AAAxiaohuangyu/2027ROBOCONSummerCamp/Docs/09FABCCCBEF35BF6D9F692935170EADD.png

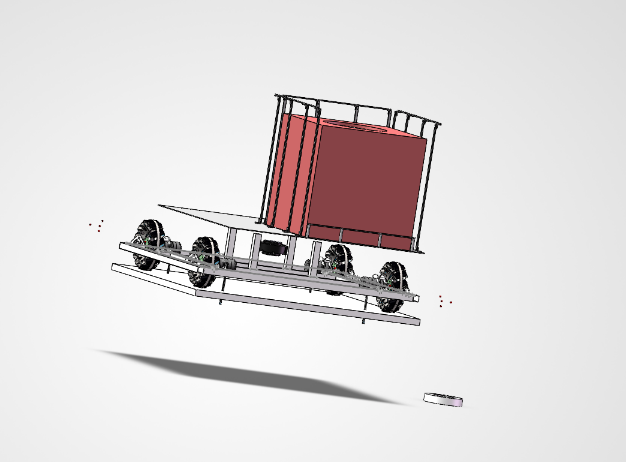
Docs/09FABCCCBEF35BF6D9F692935170EADD.png
