AAAxiaohuangyu/2027ROBOCONSummerCamp/Docs/84D7E0D3EE25D9967A4F5F0365C8E441.png

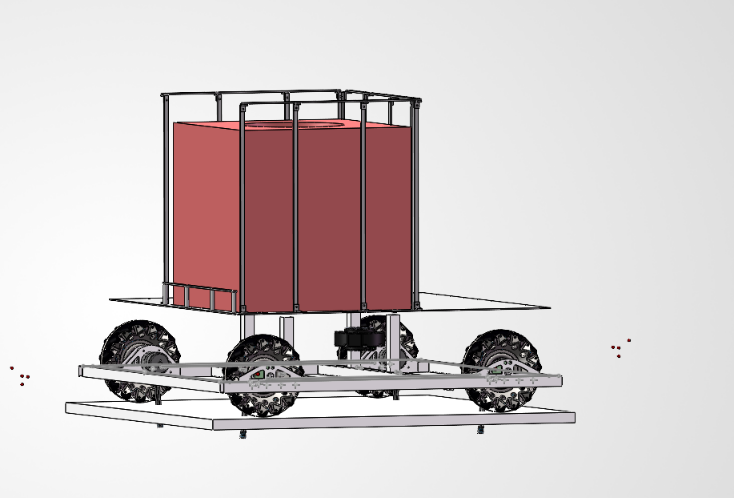
Docs/84D7E0D3EE25D9967A4F5F0365C8E441.png
