AAAxiaohuangyu/2027ROBOCONSummerCamp/Docs/97BEFC750FC481E44ABCBB74B873D2FB.png

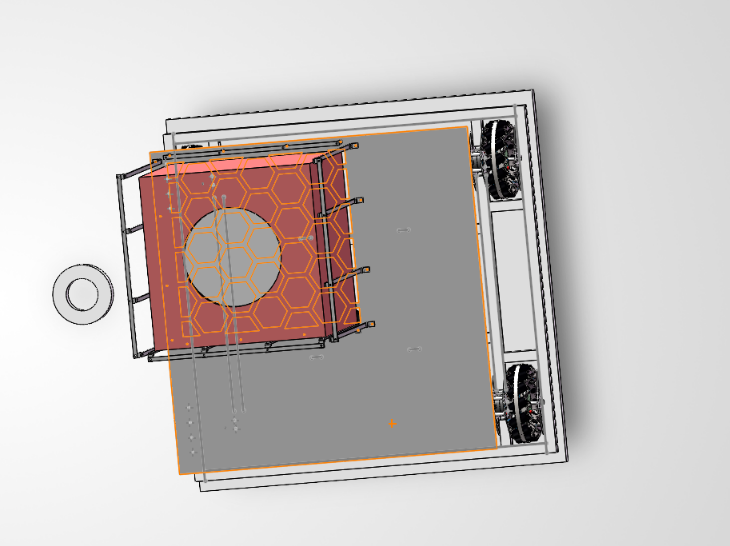
Docs/97BEFC750FC481E44ABCBB74B873D2FB.png
