AAAxiaohuangyu/2027ROBOCONSummerCamp/Docs/EFC362A279160BEA5BCEA1ED6BABFD79.png

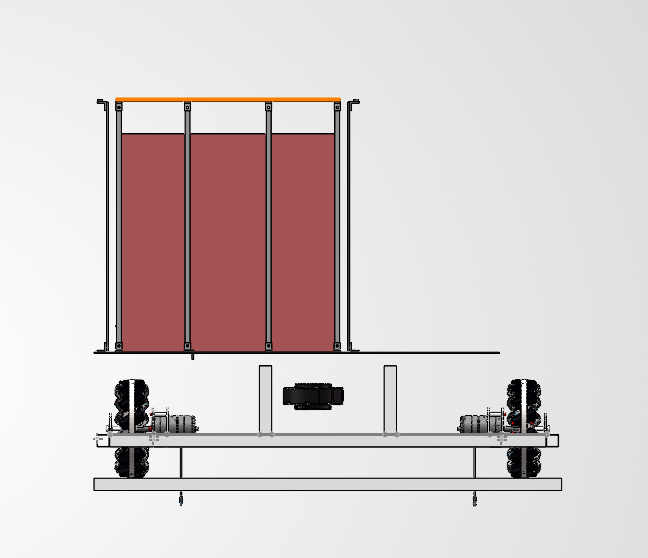
Docs/EFC362A279160BEA5BCEA1ED6BABFD79.png
