AAAxiaohuangyu/2027ROBOCONSummerCamp/Docs/SCH_Schematic1_2026-08-18.pdf

VDD 72 PB12 73 PB13 74 PB14 75 PB15 76 PD8 77 PD9 78 PD10 79 PD11 80 PD12 81 PD13 82 VSS 83 VDD 84 PD14 85 PD15 86 PG2 87 PG3 88 PG4 89 PG5 90 PG6 91 PG7 92 PG8 93 VSS 94 VDD33USB 95 PC6 96 PC7 97 PC8 98 PC9 99 PA8 100 PA9 101 PA10 102 PA11 103 PA12 104 PA13 105 VCAP 106 VSS 107 VDD 108 PA14 109 PA15 110 PC10 111 PC11 112 PC12 113 PD0 114 PD1 115 PD2 116 PD3 117 PD4 118 PD5 119 VSS 120 VDD 121 PD6 122 PD7 123 PG9 124 PG10 125 PG11 126 PG12 127 PG13 128 PG14 129 VSS 130 VDD 131 PG15 132 PB3 133 PB4 134 PB5 135 PB6 136 PB7 137 BOOT0 138 PB8 139 PB9 140 PE0 141 PE1 142 PDR_ON 143 VDD 144

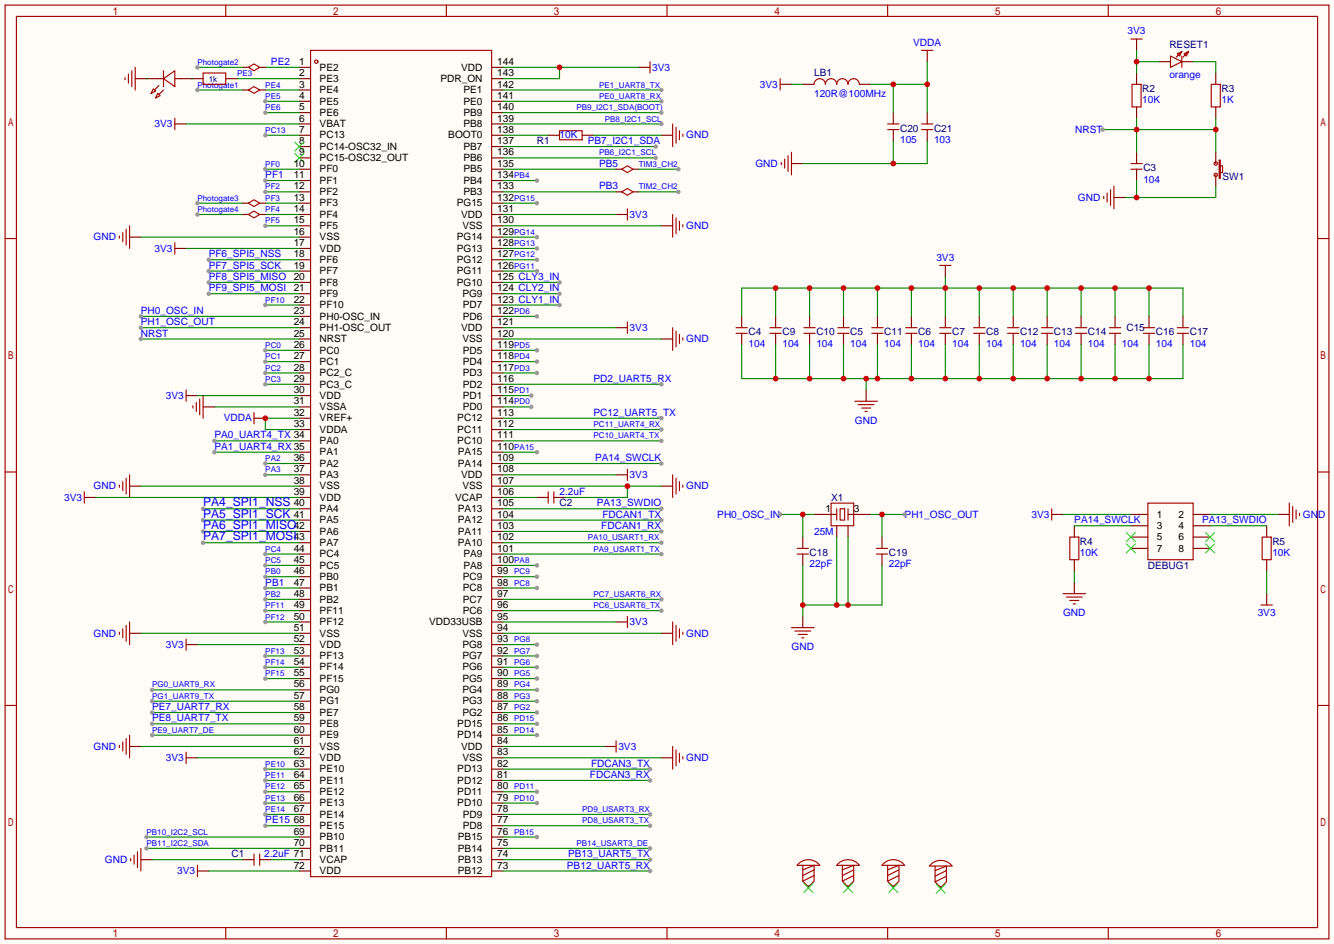
[picture p5: page 1]

# 电源降压

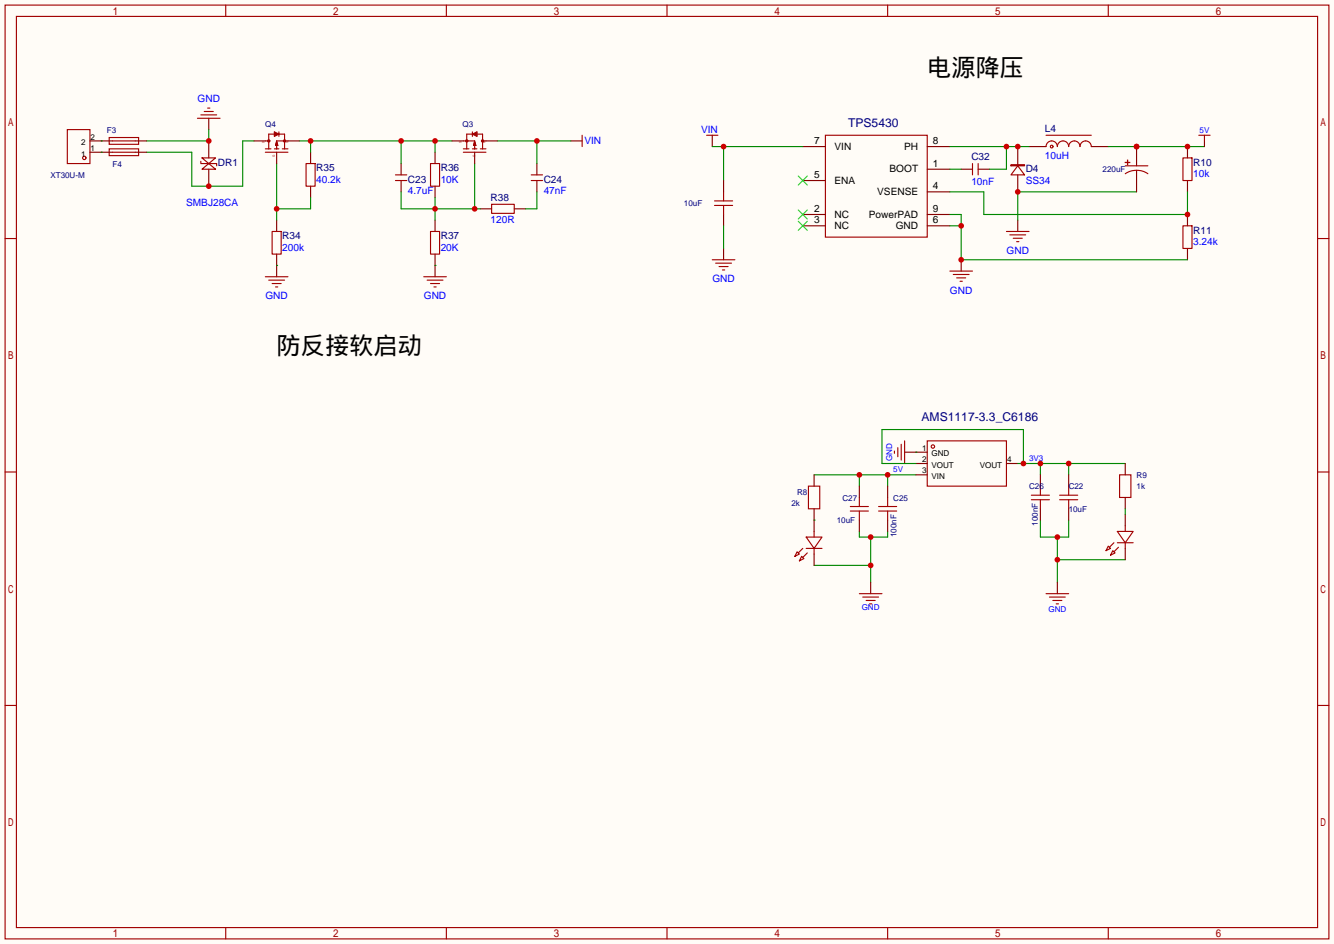
[picture p6: page 2]

# FDCAN

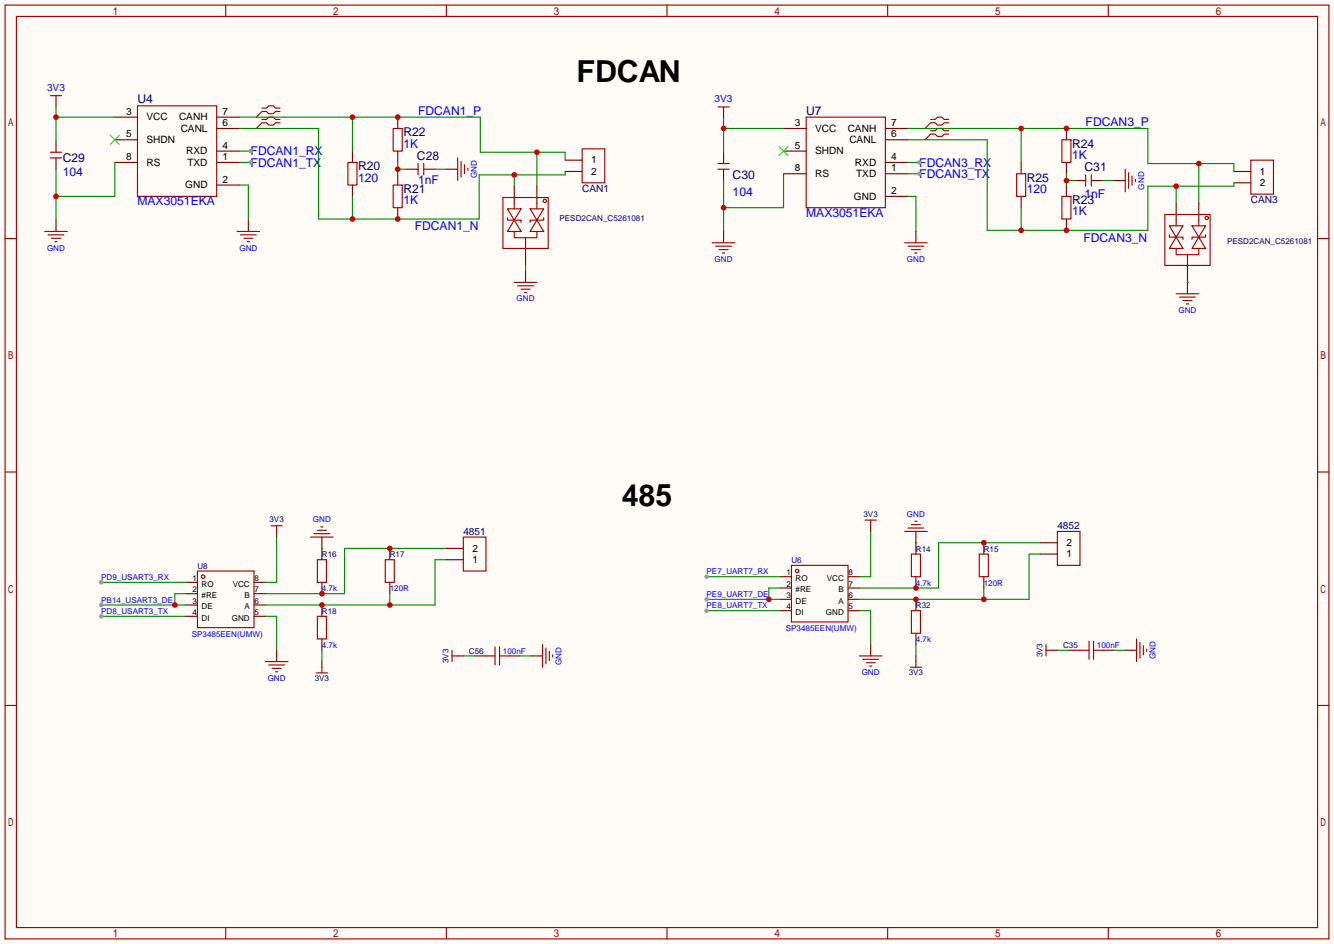
[picture p7: page 3]

# 光电门

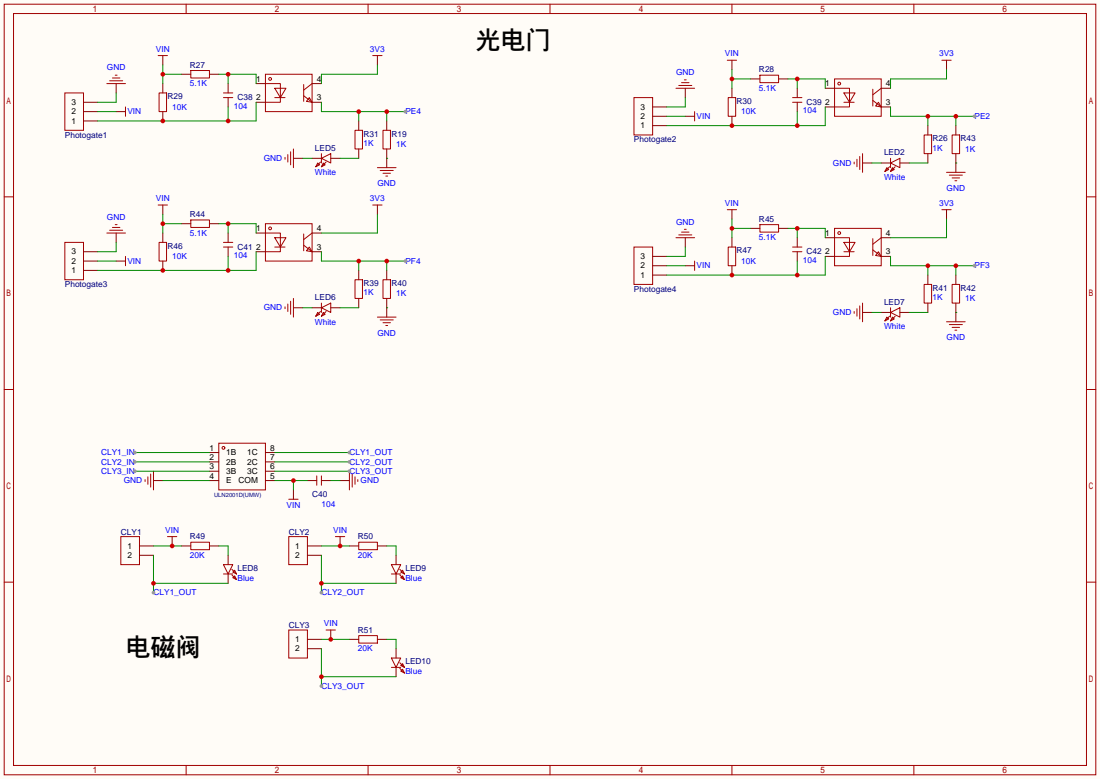
[picture p8: page 4]

# SPI

# USB to TTL

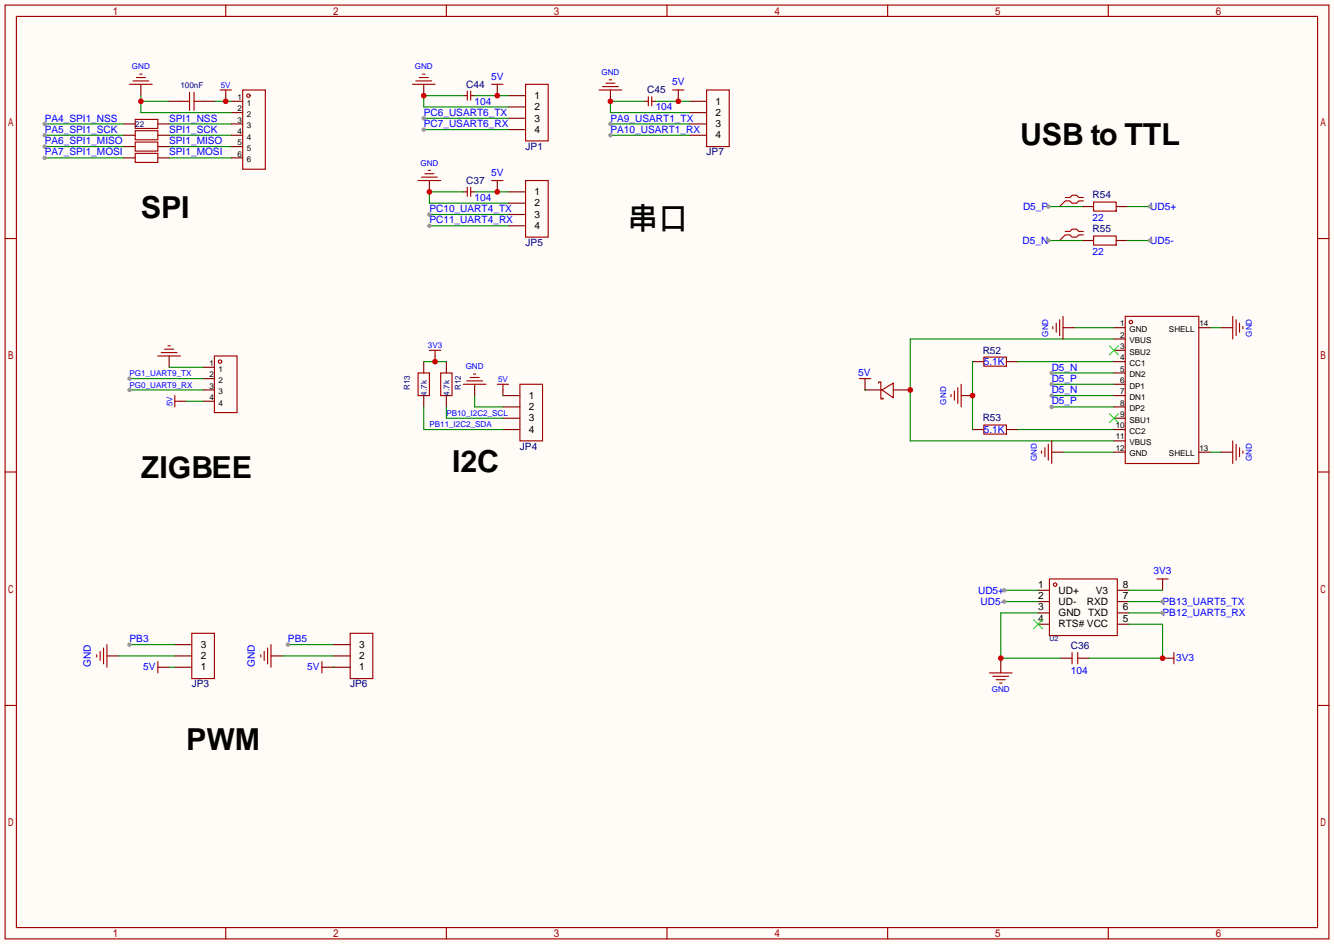
[picture p9: page 5]
