AAAxiaohuangyu/2027ROBOCONSummerCamp/RobotLower computer/RobotLower computer.ioc

Mcu.UserName=STM32H723ZGTx
PA10.Signal=USART1_RX
PA11.Signal=FDCAN1_RX
PA12.Signal=FDCAN1_TX
PA13(JTMS/SWDIO).Signal=DEBUG_JTMS-SWDIO
PA14(JTCK/SWCLK).Signal=DEBUG_JTCK-SWCLK
PA9.Signal=USART1_TX
PB12.Signal=UART5_RX
PB13.Signal=UART5_TX
PB14.Signal=USART3_DE
PB3(JTDO/TRACESWO).Signal=GPIO_Output
PB5.Signal=S_TIM3_CH2
PC10.Signal=UART4_TX
PC11.Signal=UART4_RX
PC14-OSC32_IN.Signal=RCC_OSC32_IN
PC15-OSC32_OUT.Signal=RCC_OSC32_OUT
PD12.Signal=FDCAN3_RX
PD13.Signal=FDCAN3_TX
PD7.Signal=GPIO_Output
PD8.Signal=USART3_TX
PD9.Signal=USART3_RX
PG0.Signal=UART9_RX
PG1.Signal=UART9_TX
PH0-OSC_IN.Signal=RCC_OSC_IN
PH1-OSC_OUT.Signal=RCC_OSC_OUT
