AAAxiaohuangyu/2027ROBOCONSummerCamp/RobotLower computer/APP/Common/GO_M8010.c

#include "GO_M8010.h"
#include <string.h>
#include "Core.h"

#define SATURATE(_IN, _MIN, _MAX) \
    do {                           \
        if ((_IN) <= (_MIN))      \
            (_IN) = (_MIN);       \
        else if ((_IN) >= (_MAX)) \
            (_IN) = (_MAX);       \
    } while (0)

/* CRC-16/CCITT(反射多项式0x8408,对应正规多项式0x1021)查找表,与GO-M8010-6协议一致 */
static const uint16_t crc_ccitt_table[256] = {
	0x0000, 0x1189, 0x2312, 0x329b, 0x4624, 0x57ad, 0x6536, 0x74bf,
	0x8c48, 0x9dc1, 0xaf5a, 0xbed3, 0xca6c, 0xdbe5, 0xe97e, 0xf8f7,
	0x1081, 0x0108, 0x3393, 0x221a, 0x56a5, 0x472c, 0x75b7, 0x643e,
	0x9cc9, 0x8d40, 0xbfdb, 0xae52, 0xdaed, 0xcb64, 0xf9ff, 0xe876,
	0x2102, 0x308b, 0x0210, 0x1399, 0x6726, 0x76af, 0x4434, 0x55bd,
	0xad4a, 0xbcc3, 0x8e58, 0x9fd1, 0xeb6e, 0xfae7, 0xc87c, 0xd9f5,
	0x3183, 0x200a, 0x1291, 0x0318, 0x77a7, 0x662e, 0x54b5, 0x453c,
	0xbdcb, 0xac42, 0x9ed9, 0x8f50, 0xfbef, 0xea66, 0xd8fd, 0xc974,
	0x4204, 0x538d, 0x6116, 0x709f, 0x0420, 0x15a9, 0x2732, 0x36bb,
	0xce4c, 0xdfc5, 0xed5e, 0xfcd7, 0x8868, 0x99e1, 0xab7a, 0xbaf3,
	0x5285, 0x430c, 0x7197, 0x601e, 0x14a1, 0x0528, 0x37b3, 0x263a,
	0xdecd, 0xcf44, 0xfddf, 0xec56, 0x98e9, 0x8960, 0xbbfb, 0xaa72,
	0x6306, 0x728f, 0x4014, 0x519d, 0x2522, 0x34ab, 0x0630, 0x17b9,
	0xef4e, 0xfec7, 0xcc5c, 0xddd5, 0xa96a, 0xb8e3, 0x8a78, 0x9bf1,
	0x7387, 0x620e, 0x5095, 0x411c, 0x35a3, 0x242a, 0x16b1, 0x0738,
	0xffcf, 0xee46, 0xdcdd, 0xcd54, 0xb9eb, 0xa862, 0x9af9, 0x8b70,
	0x8408, 0x9581, 0xa71a, 0xb693, 0xc22c, 0xd3a5, 0xe13e, 0xf0b7,
	0x0840, 0x19c9, 0x2b52, 0x3adb, 0x4e64, 0x5fed, 0x6d76, 0x7cff,
	0x9489, 0x8500, 0xb79b, 0xa612, 0xd2ad, 0xc324, 0xf1bf, 0xe036,
	0x18c1, 0x0948, 0x3bd3, 0x2a5a, 0x5ee5, 0x4f6c, 0x7df7, 0x6c7e,
	0xa50a, 0xb483, 0x8618, 0x9791, 0xe32e, 0xf2a7, 0xc03c, 0xd1b5,
	0x2942, 0x38cb, 0x0a50, 0x1bd9, 0x6f66, 0x7eef, 0x4c74, 0x5dfd,
	0xb58b, 0xa402, 0x9699, 0x8710, 0xf3af, 0xe226, 0xd0bd, 0xc134,
	0x39c3, 0x284a, 0x1ad1, 0x0b58, 0x7fe7, 0x6e6e, 0x5cf5, 0x4d7c,
	0xc60c, 0xd785, 0xe51e, 0xf497, 0x8028, 0x91a1, 0xa33a, 0xb2b3,
	0x4a44, 0x5bcd, 0x6956, 0x78df, 0x0c60, 0x1de9, 0x2f72, 0x3efb,
	0xd68d, 0xc704, 0xf59f, 0xe416, 0x90a9, 0x8120, 0xb3bb, 0xa232,
	0x5ac5, 0x4b4c, 0x79d7, 0x685e, 0x1ce1, 0x0d68, 0x3ff3, 0x2e7a,
	0xe70e, 0xf687, 0xc41c, 0xd595, 0xa12a, 0xb0a3, 0x8238, 0x93b1,
	0x6b46, 0x7acf, 0x4854, 0x59dd, 0x2d62, 0x3ceb, 0x0e70, 0x1ff9,
	0xf78f, 0xe606, 0xd49d, 0xc514, 0xb1ab, 0xa022, 0x92b9, 0x8330,
	0x7bc7, 0x6a4e, 0x58d5, 0x495c, 0x3de3, 0x2c6a, 0x1ef1, 0x0f78
};

static uint16_t crc_ccitt_byte(uint16_t crc, uint8_t byte)
{
    return (crc >> 8) ^ crc_ccitt_table[(crc ^ (uint16_t)byte) & 0xFFU];
}

static uint16_t crc_ccitt(uint16_t crc, const uint8_t *buffer, size_t len)
{
    while (len-- > 0U)
        crc = crc_ccitt_byte(crc, *buffer++);
    return crc;
}

static void go_m8010_put_u16_le(uint8_t *dst, uint16_t value)
{
    dst[0] = (uint8_t)(value & 0xFFU);
    dst[1] = (uint8_t)((value >> 8) & 0xFFU);
}

static void go_m8010_put_u32_le(uint8_t *dst, uint32_t value)
{
    dst[0] = (uint8_t)(value & 0xFFU);
    dst[1] = (uint8_t)((value >> 8) & 0xFFU);
    dst[2] = (uint8_t)((value >> 16) & 0xFFU);
    dst[3] = (uint8_t)((value >> 24) & 0xFFU);
}

static uint16_t go_m8010_get_u16_le(const uint8_t *src)
{
    return (uint16_t)src[0] | ((uint16_t)src[1] << 8);
}

static uint32_t go_m8010_get_u32_le(const uint8_t *src)
{
    return (uint32_t)src[0] |
           ((uint32_t)src[1] << 8) |
           ((uint32_t)src[2] << 16) |
           ((uint32_t)src[3] << 24);
}

/* 输出端->转子侧:扭矩经减速器放大,按减速比乘;速度/位置经减速器缩小,按减速比除 */
static float go_m8010_torque_output_to_rotor(float torque_output)
{
    return torque_output / GO_M8010_REDUCTION_RATIO;
}

static float go_m8010_speed_output_to_rotor(float speed_output)
{
    return speed_output * GO_M8010_REDUCTION_RATIO;
}

static float go_m8010_position_output_to_rotor(float position_output)
{
    return position_output * GO_M8010_REDUCTION_RATIO;
}

/* 转子侧->输出端:与上面互为逆运算 */
static float go_m8010_position_rotor_to_output(float position_rotor)
{
    return position_rotor / GO_M8010_REDUCTION_RATIO;
}

/* 按GO-M8010-6协议打包17字节控制帧,限幅后转换为定点数,不回写调用者原始指令 */
static void GOM8010PackControlFrame(GOM8010Motor_TypeDef *motor)
{
    GOM8010Control_TypeDef *control = &motor->control;
    uint8_t *frame = control->packet.bytes;
    uint8_t id = motor->id;
    uint8_t mode = control->mode;
    uint8_t timeout = control->timeout;
    float torque = go_m8010_torque_output_to_rotor(control->torque);
    float speed = go_m8010_speed_output_to_rotor(control->speed);
    /* control->position是软件零点坐标系(与feedback->position同系),打包发送前需加回position_offset
       换算回电机原始坐标系,否则电机实际运动位置会偏差一个position_offset */
    float position = go_m8010_position_output_to_rotor(control->position + motor->feedback.position_offset);
    float kp = control->kp;
    float kd = control->kd;
    int16_t torque_raw;
    int16_t speed_raw;
    int32_t position_raw;
    int16_t kp_raw;
    int16_t kd_raw;
    uint16_t crc;

    if (id > 15U)      /* id占4bit */
        id = 15U;
    if (mode > 2U)     /* 0=锁定,1=FOC闭环(力位速混合控制,常用模式),2=编码器校准 */
        mode = 2U;
    if (timeout > 1U)
        timeout = 1U;
    SATURATE(kp, 0.0f, 25.599f);              /* kp/kd满量程25.6,对应16bit定点 */
    SATURATE(kd, 0.0f, 25.599f);
    SATURATE(torque, -4.0f, 4.0f);            /* 转子侧额定最大转矩±4N*m(已由输出端换算而来) */
    SATURATE(speed, -804.0f, 804.0f);         /* 转子侧最大转速±804rad/s,由16bit定点满量程反推 */
    SATURATE(position, -411774.0f, 411774.0f); /* 转子侧位置范围,由32bit定点满量程反推 */

    torque_raw = (int16_t)(torque * 256.0f);
    speed_raw = (int16_t)(speed / PI2 * 256.0f);
    position_raw = (int32_t)(position / PI2 * 32768.0f);
    kp_raw = (int16_t)(kp / 25.6f * 32768.0f);
    kd_raw = (int16_t)(kd / 25.6f * 32768.0f);

    frame[0] = 0xFEU; /* 控制帧帧头 */
    frame[1] = 0xEEU;
    frame[2] = (uint8_t)((id & 0x0FU) |
                         ((mode & 0x07U) << 4) |
                         ((timeout & 0x01U) << 7));
    go_m8010_put_u16_le(&frame[3], (uint16_t)torque_raw);
    go_m8010_put_u16_le(&frame[5], (uint16_t)speed_raw);
    go_m8010_put_u32_le(&frame[7], (uint32_t)position_raw);
    go_m8010_put_u16_le(&frame[11], (uint16_t)kp_raw);
    go_m8010_put_u16_le(&frame[13], (uint16_t)kd_raw);

    crc = crc_ccitt(0U, frame, 15U); /* CRC覆盖帧头+数据共15字节 */
    go_m8010_put_u16_le(&frame[15], crc);
}

/* 校验16字节反馈帧并提取位置；第一帧作为软件零点。 */
static uint8_t GOM8010ParseFeedbackFrame(GOM8010Feedback_TypeDef *feedback, const uint8_t *frame)
{
    uint16_t received_crc;
    uint16_t calculated_crc;
    int32_t position_raw;
    float position_output;

    if ((frame[0] != 0xFDU) || (frame[1] != 0xEEU))
        return 0U;

    calculated_crc = crc_ccitt(0U, frame, 14U);
    received_crc = go_m8010_get_u16_le(&frame[14]);
    if (received_crc != calculated_crc)
        return 0U;

    position_raw = (int32_t)go_m8010_get_u32_le(&frame[7]);
    position_output = go_m8010_position_rotor_to_output((float)position_raw / 32768.0f * PI2);
    if (feedback->position_initialized == 0U)
    {
        feedback->position_offset = position_output;
        feedback->position_initialized = 1U;
    }

    feedback->position = position_output - feedback->position_offset;
    return 1U;
}

static void GOM8010MotorParseFeedback(GOM8010Motor_TypeDef *motor, uint16_t size)
{
    uint16_t offset;
    const uint8_t *latest_frame = NULL;

    if (size > GO_M8010_RX_DMA_BUFFER_SIZE)
        size = GO_M8010_RX_DMA_BUFFER_SIZE;

    for (offset = 0U; (offset + GO_M8010_FEEDBACK_FRAME_SIZE) <= size; offset++)
    {
        if (GOM8010ParseFeedbackFrame(&motor->feedback, &motor->feedback.packet.bytes[offset]) != 0U)
        {
            latest_frame = &motor->feedback.packet.bytes[offset];
        }
    }

    if (latest_frame != NULL)
        memmove(motor->feedback.packet.bytes, latest_frame, GO_M8010_FEEDBACK_FRAME_SIZE);
}

static void GOM8010MotorStartRx(GOM8010Motor_TypeDef *motor)
{
    HAL_UARTEx_ReceiveToIdle_DMA(motor->huart, motor->feedback.packet.bytes, GO_M8010_RX_DMA_BUFFER_SIZE);
    __HAL_DMA_DISABLE_IT(motor->huart->hdmarx, DMA_IT_HT);
}

void GOM8010MotorInit(GOM8010Motor_TypeDef *motor, uint8_t id, UART_HandleTypeDef *huart)
{
    memset(motor, 0, sizeof(*motor));
    motor->id = id;
    motor->huart = huart;
    motor->control.mode = 1U;

    motor->control.position_param.a_max = GO_M8010_POS_CTRL_A_MAX;
    motor->control.position_param.v_max = GO_M8010_POS_CTRL_V_MAX;
    motor->control.position_param.j = GO_M8010_POS_CTRL_J;
    motor->control.position_param.kp = GO_M8010_POS_CTRL_KP;
    motor->control.position_param.kd = GO_M8010_POS_CTRL_KD;
    motor->control.velocity_param.kp = GO_M8010_VEL_CTRL_KP;
    motor->control.velocity_param.kd = GO_M8010_VEL_CTRL_KD;

    SpeedPlanInit(&motor->control.plan, motor->control.position_param.a_max, motor->control.position_param.v_max, motor->control.position_param.j, 0.0f);
    motor->control.ctrl_mode = GOM8010_CTRL_MODE_POSITION;
    motor->control.kp = motor->control.position_param.kp;
    motor->control.kd = motor->control.position_param.kd;

    GOM8010MotorStartRx(motor);
}

void GOM8010MotorSetTarget(GOM8010Motor_TypeDef *motor, float position_target)
{
    motor->control.ctrl_mode = GOM8010_CTRL_MODE_POSITION;
    motor->control.position_target = position_target;
    motor->control.plan.state = init;
}

void GOM8010MotorSetVelocityTarget(GOM8010Motor_TypeDef *motor, float velocity_target)
{
    motor->control.ctrl_mode = GOM8010_CTRL_MODE_VELOCITY;
    motor->control.velocity_target = velocity_target;
}

void GOM8010MotorSetTorqueFeedforward(GOM8010Motor_TypeDef *motor, float torque_feedforward)
{
    motor->control.torque_feedforward = torque_feedforward;
}

void GOM8010MotorUpdate(GOM8010Motor_TypeDef *motor)
{
    GOM8010Control_TypeDef *control = &motor->control;
    float position_actual = motor->feedback.position;

    control->mode = 1U;
    control->timeout = 0U;
    control->torque = control->torque_feedforward;

    if (control->ctrl_mode == GOM8010_CTRL_MODE_VELOCITY)
    {
        control->kp = control->velocity_param.kp;
        control->kd = control->velocity_param.kd;
        control->position = position_actual;
        control->speed = control->velocity_target;
    }
    else
    {
        SpeedPlanUpdate(&control->plan, position_actual, control->position_target);
        control->kp = control->position_param.kp;
        control->kd = control->position_param.kd;
        control->position = control->plan.position_initial + control->plan.direction_flag * control->plan.s;
        control->speed = control->plan.v * control->plan.direction_flag;
    }

    GOM8010PackControlFrame(motor);
    HAL_UART_Transmit_DMA(motor->huart, control->packet.bytes, GO_M8010_CONTROL_FRAME_SIZE);
}

void GOM8010MotorRxEvent(GOM8010Motor_TypeDef *motor, UART_HandleTypeDef *huart, uint16_t size)
{
    if (huart == NULL || motor->huart == NULL || motor->huart->Instance != huart->Instance)
        return;
    GOM8010MotorParseFeedback(motor, size);
    GOM8010MotorStartRx(motor);
}

void GOM8010MotorRxErrorEvent(GOM8010Motor_TypeDef *motor, UART_HandleTypeDef *huart)
{
    if (huart == NULL || motor->huart == NULL || motor->huart->Instance != huart->Instance)
        return;

    GOM8010MotorStartRx(motor);
}
