AAAxiaohuangyu/2027ROBOCONSummerCamp/(commit log)

2026-08-10 Add STM32CubeMX+FreeRTOS lower-computer skeleton (chassis/flip/pickup/stack)
    [RobotLower computer.ioc]
2026-08-10 进行了基础的时钟树配置,FDCAN配置,USART配置,FreeRTOS配置
2026-08-10 feat(common): 新增FDCAN总线1与调试USART1的共享语义化宏定义
2026-08-10 feat(common): 新增FDCAN公共收发接口(fdcan_common)
    提供 FDCANStandardInit（标准ID范围过滤器配置+启动）与 FDCANSendStandard
    （标准帧发送）供各模块复用。
2026-08-10 chore(common): 将fdcan_common接入Keil工程
    补充 APP/Common 头文件搜索路径，并把 fdcan_common.c 加入编译分组。
2026-08-10 style(common): 完善fdcan_common注释与格式
2026-08-10 refactor(common): bsp_config总线句柄改为取地址形式并新增DEBUG_UART_INSTANCE
    FDCAN1启用Normal模式;清理freertos.c格式并移除遗留的测试任务引用
2026-08-10 docs: 更新2026夏令营赛题文档
2026-08-10 docs: add J60 joint product manual
2026-08-10 feat(common): 新增ControlAlgorithm串级PID公共算法模块
    封装单环PID(PIDCalc)与位置-速度串级PID(CascadePIDCalc),
    含输出限幅与积分限幅;接入Keil工程Common分组
2026-08-11 feat(common): 新增SpeedPlan七段S曲线速度规划公共算法模块
    封装SpeedPlanInit/SpeedPlanUpdate,内部按1ms子步长积分且按HAL_GetTick()
    计算真实dt,调用频率不影响规划精度;接入Keil工程Common分组
2026-08-11 feat(common): 新增GO-M8010-6电机RS485驱动模块
    - 控制/反馈帧打包解析、CRC-16/CCITT校验等内部实现收敛至.c,头文件只暴露类型与3个公共接口
    - 支持多UART实例(huart字段),避免全局固定USART_NUM
    - 发送采用DMA,接收由上层空闲线中断驱动后调用GOM8010MotorParseFeedback解析,驱动本身不含中断回调
    - 类型/函数统一GOM8010前缀命名,对齐DJIMotor等驱动的品牌命名规范,避免多品牌电机命名冲突
2026-08-11 feat(common): 新增GO-M8010-6电机驱动模块
    支持控制帧打包/反馈帧解析,对外接口统一使用输出端力矩/转速/位置,内部按6.33减速比与协议约定的转子侧数据互相换算。
2026-08-11 feat(common): GO_M8010驱动内置速度规划位置环API
    新增GOM8010PositionControl_TypeDef,把SpeedPlan规划与力位速混合控制
    封装为驱动API(Init/SetTarget/Update),kp/kd及规划参数固化为调好的默认值。
2026-08-12 refactor(common): GO_M8010电机结构体模仿M3508模式重构,新增M3508驱动模块
    - GO_M8010驱动引入GOM8010Motor_TypeDef大结构体,内含control/feedback子结构体,与M3508驱动风格保持一致(GO电机走RS485点对点通信,不引入分组结构)
    - 新增APP/Common/M3508.c/h(原APP/Test/DJIMotor.c/h重命名迁移),标识符同步由DJIMotor/DJI_MOTOR/DJI_M3508前缀改为M3508
2026-08-12 feat(common): 新增bsp_callback回调统一管理占位文件,CANBUS1切换至hfdcan2
    - 新增APP/Common/bsp_callback.c/h作为后续统一承载HAL弱回调(HAL_UARTEx_RxEventCallback等)分发逻辑的占位文件,避免多任务文件各自定义同名回调导致链接冲突
    - bsp_config.h的CANBUS1_HANDLE由hfdcan1改为hfdcan2
2026-08-12 feat(common): 新增J60关节电机CAN驱动,GO_M8010/J60支持前馈扭矩由上层指定
    - 新增APP/Common/J60.c/h:J60关节电机CAN通信协议驱动,内置速度规划位置环,与GO_M8010风格一致
    - GO_M8010/J60的torque前馈不再硬编码为0,新增GOM8010MotorSetTorqueFeedforward/J60MotorSetTorqueFeedforward,可由上层像目标位置/速度一样指定前馈扭矩
2026-08-12 feat(common): J60/M3508驱动写死最终调参参数,工程新增J60/M3508/bsp_callback源文件
    按GO_M8010驱动风格,将J60位置环kp/kd、M3508速度环+电流环级联PID的最终调参值
    直接写死在各自头文件的默认参数宏中;同步将新增的J60.c/M3508.c/bsp_callback.c
    加入Keil工程文件,使其参与编译。
2026-08-12 feat(common): 新增机械臂末端坐标控制模块(J60升降+GO前伸+GO自转)
    RoboticArm在J60/GO_M8010驱动之上建模三自由度末端执行器:升降高度、
    前伸距离共同决定末端点end_x/end_z,另有末端自转角度rod_rotation与
    自转电机转角直接相等;安装位置/换算系数/杆长均以宏定义占位,待实测标定。
2026-08-12 chore: 移除空的APP/Stack占位目录
2026-08-13 feat(common): 机械臂标定升降/前后减速比,新增末端z向固定偏移量
    ROBOTICARM_LIFT_K/ROBOTICARM_FORWARD_K填入实测减速比0.00955;新增
    ROBOTICARM_END_Z_OFFSET(实测84mm),修正末端结构导致的z向固定高出量,
    末端坐标正解/反解均已同步该偏移。
    [RoboticArm.c, RoboticArm.h]
2026-08-13 feat(common): 机械臂全局实例定义,新增Core应用层文件,文档补充
2026-08-13 feat(core): Core状态机骨架接入机械臂实例,移除RoboticArm独立全局实例
2026-08-13 feat(core): RobotInit接入机械臂初始化,bsp_config.h迁移至Core并新增机械臂外设占位宏
2026-08-13 feat(zigbee): 接收指针参数重构,移除全局实例依赖
    - 所有Zigbee_*函数改为接收ZigbeeHandle_TypeDef指针参数
    - 符合RoboticArm模块指针传递的设计模式
    - HAL_UARTEx_RxEventCallback内部路由到Robot.zigbee实例
    - 新增flip.c/flip.h和zigbee驱动完整实现
    [Core.h, zigbee.c, zigbee.h]
2026-08-13 feat(common): add gas pump GPIO driver
    Control gas pump on/off via a single GPIO pin for robotic arm grip/release actions.
2026-08-13 feat(core): add robot state machine skeleton and update loop
    Introduce RobotState_TypeDef with idle state and wire RobotStateUpdate/RoboticArmUpdate into dedicated update loops.
2026-08-13 feat(pickup): add KFS pickup state machine
    Extract shared PositionReached/RotationReached helpers from Flip into RoboticArm and reuse them to drive the new Pickup state machine.
    [RoboticArm.c, RoboticArm.h]
2026-08-13 fix(common): add osDelay in RoboticArmUpdate loop
    Yield CPU periodically inside the update loop to avoid starving other RTOS tasks.
    [RoboticArm.c]
2026-08-13 feat(chassis): add mecanum chassis module, move RoboticArm to own directory
    Adds Chassis/chassis.c,h with mecanum kinematics (chassis_mecanum.c,h) and a
    centralized chassis_config.h for calibration and drivetrain unit-conversion
    constants. Chassis_TypeDef groups drive/displacement-plan/pose sub-structs
    instead of flat fields. Relocates RoboticArm from APP/Common to its own
    APP/Roboticarm directory, and updates the Keil project/include paths and
    VS Code IntelliSense config accordingly.
2026-08-13 feat(core): wire chassis module into robot state, dispatch its CAN feedback
    Init the chassis in RobotInit and route its FDCAN feedback through the
    shared HAL callback dispatcher alongside the lift motor. Rename zigbee.h's
    protocol payload struct (ZigbeeChassisCmd_TypeDef) to stop colliding with
    chassis.h's Chassis_TypeDef, which broke the build with a redeclaration
    error and made Robot.chassis resolve to the wrong (fieldless) type.
    [Core.c, Core.h, bsp_callback.c, bsp_callback.h, bsp_config.h, zigbee.c, zigbee.h]
2026-08-13 fix(core,chassis,flip): guard peripheral init, avoid div-by-zero, wire pickup state
    - Core: only start FDCAN/UART receive for peripherals whose handles are
    already assigned in bsp_config.h, so unassigned placeholders don't
    crash init
    - Core: include Pickup.h and add pick_state to Robot_TypeDef
    - chassis: avoid 0/0 NaN when translation target distance is zero
    - bsp_config: set CHASSIS_CTRL_ID placeholder to 0x200
    - flip: express rotation angles/tolerance in radians (PI2) to match
    RoboticArmSetRodRotation/RotationReached units
    [Core.c, Core.h, bsp_config.h, chassis.c]
2026-08-14 feat(core): implement full KFS pickup state machine with vision handoff
    Wire up MOVE1-MOVE6/FLIP/VISION_WAIT states to drive the robot through
    flip, return, per-KFS vision-selected pickup, and slope climb; add
    weak vision request/ready hooks with a default pass-through
    implementation, and fix flip state re-entry so callers can restart
    FLIP_STATE_DONE cleanly.
    [Core.c, Core.h]
2026-08-14 refactor(core): encapsulate pickup fields into RobotPickup_TypeDef, sync CubeMX peripherals
    Group pick_state/kfs_last_index/kfs_target_index/pickup_return_state/
    vision_next_state/vision_request_sent under Robot.pickup for a cleaner
    top-level Robot_TypeDef. Also pulls in CubeMX-regenerated FDCAN/USART/DMA
    peripheral config and adds the CAN protocol reference doc.
2026-08-14 refactor(zigbee): split chassis translation command into vx/vy components
    Replace speed/direction_angle pair with speed_vx/speed_vy so the chassis
    command carries independent x/y velocity components instead of a
    magnitude+angle pair.
    [zigbee.c, zigbee.h]
2026-08-14 feat(core): enable robotic arm at init, wire GO motor UART handles
    Assign huart5 to forward/rotate GO motor RS485 handles and call
    RoboticArmEnable during RobotInit.
2026-08-14 refactor(motor): rework GO_M8010 driver around RS485 bus groups
    Replace the per-motor GOM8010Motor* API with a GOM8010Group* API that
    owns a shared bus arbiter, so multiple motors on the same half-duplex
    RS485 line take turns requesting/responding instead of colliding.
    RoboticArm's forward/rotate motors move into a single go_motors group;
    bsp_callback's RX dispatch and Core's init no longer poke motor/UART
    fields directly, delegating to GOM8010GroupRxEvent/GOM8010GroupUpdate.
    [Core.c, GO_M8010.c, GO_M8010.h, RoboticArm.c, RoboticArm.h, bsp_callback.c]
2026-08-14 feat(vision): add vision module, wire KFS colour check into pickup state machine
    Adds the Vision UART frame parser and dispatches its RX event from the
    shared HAL_UARTEx_RxEventCallback. ROBOT_STATE_VISION_WAIT now decides
    whether to pick up the candidate KFS or skip to the next one based on
    next_colour vs VISION_CORRECT_COLOUR, replacing the placeholder
    request/ready function pair with a direct read of the vision handle.
    [Core.c, Core.h, bsp_callback.c, bsp_config.h, vision.c, vision.h]
2026-08-14 fix(core): cast VISION_UART_HANDLE null placeholder to UART_HandleTypeDef*
    [bsp_config.h]
2026-08-14 refactor(core): centralize ZIGBEE_UART_HANDLE in bsp_config.h
    Move the zigbee UART handle macro out of zigbee.h into bsp_config.h so all UART handle mappings live in one place alongside VISION_UART_HANDLE.
2026-08-15 feat(bsp): centralize encoder peripheral config and unify PI constant
    Add encoder.c/h and its FDCAN handle/node-id macros in bsp_config.h,
    consolidate PI into BSP_PI, and retune M3508 speed/current loop gains.
2026-08-15 feat(chassis): set actual mecanum geometry and wire up chassis FDCAN handle
    Fill in real wheel radius, wheelbase, track, and gear ratio values
    (previously placeholder zeros), and point CHASSIS_FDCAN_HANDLE at
    hfdcan1 now that the peripheral assignment is known. Drop the unused
    CANBUS1_HANDLE and DEBUG_UART_HANDLE macros.
2026-08-15 增加了关节电机两种模式
2026-08-15 fix(motor): 调整 GO_M8010/J60 头文件宏定义
    [GO_M8010.h, J60.h]
2026-08-15 fix(motor): 固定GO_M8010/J60定速模式KD增益为实测调参值
    GO_M8010_VEL_CTRL_KD改为0.3f,J60_VEL_CTRL_KD改为3.5f,不再沿用位置
    模式的KD(GO_M8010_POS_CTRL_KD/J60_POS_CTRL_KD)。
    [GO_M8010.h, J60.h]
2026-08-16 feat(roboticarm): 新增升降机构重力补偿宏定义
    新增LOAD_MASS/STRATEGYALGORITHM_GRAVITY_ACCEL/GravityCompensationLift宏,用于J60升降电机前馈扭矩补偿;补充zigbee.h中Joint/Grab指令取值注释;同步Keil工程文件改动。
2026-08-16 feat(roboticarm): RoboticArmSetEndPosition增加升降机构前馈力矩参数
    调用处统一传入GravityCompensationLift实现重力补偿。
2026-08-16 更新READEME.md
2026-08-16 处理double转floatwarning
2026-08-16 feat(core): 实现手动控制状态机,同步zigbee/vision数据结构变更
    - core: MANUAL状态下按zigbee.explained_data持续下发底盘速度、机械臂三电机定速目标,抓取/急停联动气泵开关
    - zigbee: 新增explained_data字段持久保存最新解析帧,不随Zigbee_Receive消费清空;Zigbee_Init补充清零初始化
    - vision: 新增current_colour与小车x/y坐标解析、CRC8校验,调整DMA接收缓冲宏定义
2026-08-16 修改机械臂质量参数
2026-08-18 修改外设句柄与引脚
2026-08-18 新增底盘/机械臂测试模块,同步FreeRTOS任务与工程配置
2026-08-18 修改了zigbee协议
2026-08-18 修改了底盘电机运动方向
2026-08-18 电机与码盘已同时跑通
2026-08-18 增加了栈,修改了encoder的filter
2026-08-18 码盘已调完,准备补偿摩擦,跑点
2026-08-18 摩擦力补偿暂时完成
2026-08-18 完成了基础的速度规划跑点
2026-08-19 添加了跟踪器代码
2026-08-19 码盘init bug排查
2026-08-19 过滤器配置
2026-08-19 跑点基本完成
2026-08-19 增加了底盘正解算
2026-08-19 加快了底盘速度规划
2026-08-19 测试转弯
2026-08-19 编码器软件实现再次多圈
2026-08-20 跟踪器优化与速度规划x,y独立
2026-08-20 速度规划分离后bug修改
2026-08-20 追踪器参数初步确定
2026-08-20 底盘基本完成,未融合imu
2026-08-20 添加了imu
2026-08-20 yaw环调参前
2026-08-20 yaw环参数初试
2026-08-21 x,y跟踪参数初步调试
2026-08-21 encoder坐标转换完成
2026-08-21 1.2m/s参数调整完成
2026-08-21 一区任务完成初步验证
2026-08-22 任务一底盘定位初步完成
2026-08-22 任务一转到任务二基本完成
2026-08-22 一区二区底盘任务基本完成
2026-08-23 测试上斜坡
2026-08-23 上斜坡基本完成
2026-08-23 底盘自动化控制基本完成
2026-08-23 zigbee调试前
2026-08-24 初步集成了手柄控制
2026-08-24 手柄控制基本完成
2026-08-24 与视觉完成基本对接
2026-08-24 完善了三次取块代码
2026-08-25 完成了与视觉对接后底盘的运动修改
2026-08-25 纯底盘代码调整完毕
2026-08-25 代码移植到core中
2026-08-25 移植test代码到core中(已debug)
2026-08-25 修改了跟踪器的参数,机械臂代码合并前
2026-08-25 舵机,电磁阀,气泵驱动整合完成
2026-08-25 视觉修改串口
2026-08-26 增加了GO,J60软件零点,修改了速度规划参数
2026-08-26 完成了机械臂底层驱动置换
2026-08-26 修改了flip相关代码
2026-08-26 pickup相关代码修改完成
2026-08-26 只剩舵机bug未修复
2026-08-26 flip测试初,等待电路机械修改
2026-08-27 flip测试前
2026-08-27 串口watch前
2026-08-28 go电机bug修复
2026-08-28 机械调整机构前
2026-08-28 pickup状态机内部逻辑未更改完毕
2026-08-29 一区已完成
2026-08-29 二区调试开始前
2026-08-29 pickup结构性代码完成
2026-08-29 pickup代码基本架构完成
2026-08-29 pickup优化
2026-08-29 pickup调试
2026-08-29 红蓝场地切换
2026-08-29 单独测试pickup
2026-08-29 1,2区全流程代码提交
2026-08-29 1,2区全流程代码提交2
2026-08-29 1,2区全流程代码优化0
2026-08-29 舵机角度修正完成
2026-08-29 全流程验证完毕
2026-08-30 红区版本
2026-08-30 蓝区重试前
2026-08-30 蓝区重试后第二版
2026-08-30 蓝区重试后3
